jo1102/Hardware-Hack/audio/diagram_transistor.png

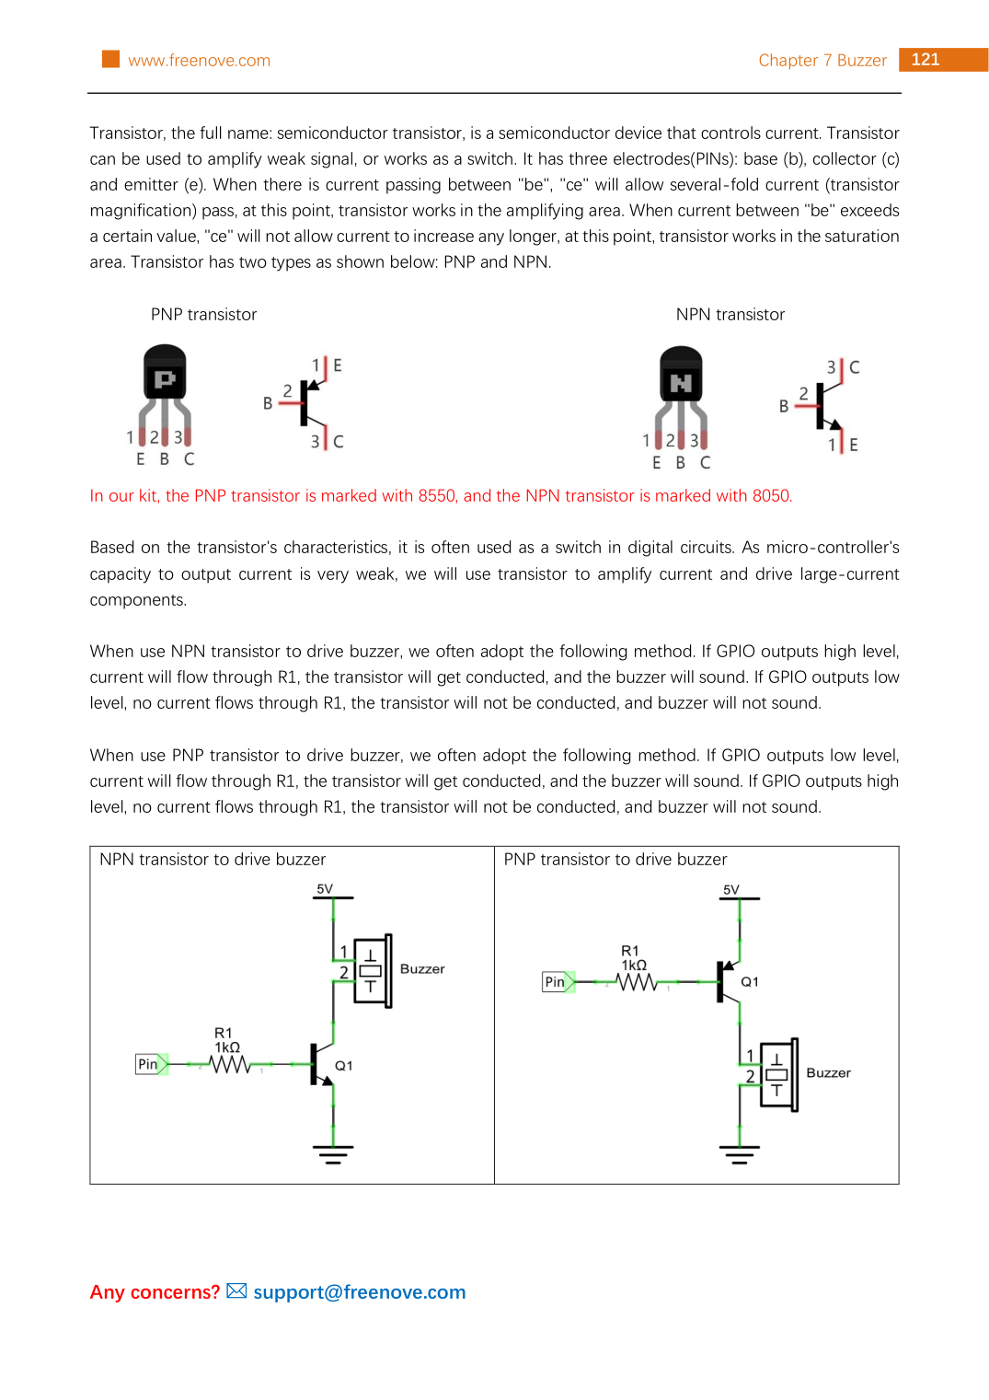
audio/diagram_transistor.png
