jo1102/Hardware-Hack/camera/XiaoCam/XiaoCam.ino

#include <Arduino.h>
#include "esp_camera.h"
#include <WiFi.h>

// The Check-in webcam: an 800x600 stream over WiFi, as CameraWebServer always
// was. Person detection runs on the laptop instead (site/bridge.py, YOLOX) -
// a model small enough for this chip could not tell a person from an empty
// room. Over USB it only says where its stream is, every two seconds, so the
// bridge never has to search the network for it.

// ===========================
// Select camera model in board_config.h
// ===========================
#include "board_config.h"

// ===========================
// WiFi credentials
// ===========================
// Kept out of git. Copy wifi_secrets.example.h to wifi_secrets.h in this
// folder and put your own network in it:
//
//     cp camera/XiaoCam/wifi_secrets.example.h camera/XiaoCam/wifi_secrets.h
//
// The __has_include guard means a fresh clone still COMPILES without that
// file - it just will not connect, and the compiler says why. Breaking the
// build for a missing secret would be a worse trade.
#if __has_include("wifi_secrets.h")
  #include "wifi_secrets.h"
#else
  #define WIFI_SSID     "YOUR_WIFI_NAME"
  #define WIFI_PASSWORD "YOUR_WIFI_PASSWORD"
  #warning "camera/XiaoCam/wifi_secrets.h missing - copy wifi_secrets.example.h to it"
#endif

const char *ssid = WIFI_SSID;
const char *password = WIFI_PASSWORD;

void startCameraServer();
void setupLedFlash();

void setup() {
  Serial.begin(115200);
  Serial.setDebugOutput(true);
  Serial.println();

  camera_config_t config;
  config.ledc_channel = LEDC_CHANNEL_0;
  config.ledc_timer = LEDC_TIMER_0;
  config.pin_d0 = Y2_GPIO_NUM;
  config.pin_d1 = Y3_GPIO_NUM;
  config.pin_d2 = Y4_GPIO_NUM;
  config.pin_d3 = Y5_GPIO_NUM;
  config.pin_d4 = Y6_GPIO_NUM;
  config.pin_d5 = Y7_GPIO_NUM;
  config.pin_d6 = Y8_GPIO_NUM;
  config.pin_d7 = Y9_GPIO_NUM;
  config.pin_xclk = XCLK_GPIO_NUM;
  config.pin_pclk = PCLK_GPIO_NUM;
  config.pin_vsync = VSYNC_GPIO_NUM;
  config.pin_href = HREF_GPIO_NUM;
  config.pin_sccb_sda = SIOD_GPIO_NUM;
  config.pin_sccb_scl = SIOC_GPIO_NUM;
  config.pin_pwdn = PWDN_GPIO_NUM;
  config.pin_reset = RESET_GPIO_NUM;
  config.xclk_freq_hz = 20000000;
  config.frame_size = FRAMESIZE_UXGA;
  config.pixel_format = PIXFORMAT_JPEG;  // for streaming
  //config.pixel_format = PIXFORMAT_RGB565; // for face detection/recognition
  config.grab_mode = CAMERA_GRAB_WHEN_EMPTY;
  config.fb_location = CAMERA_FB_IN_PSRAM;
  config.jpeg_quality = 12;
  config.fb_count = 1;

  // if PSRAM IC present, init with UXGA resolution and higher JPEG quality
  //                      for larger pre-allocated frame buffer.
  if (config.pixel_format == PIXFORMAT_JPEG) {
    if (psramFound()) {
      config.jpeg_quality = 10;
      config.fb_count = 2;
      config.grab_mode = CAMERA_GRAB_LATEST;
    } else {
      // Limit the frame size when PSRAM is not available
      config.frame_size = FRAMESIZE_SVGA;
      config.fb_location = CAMERA_FB_IN_DRAM;
    }
  } else {
    // Best option for face detection/recognition
    config.frame_size = FRAMESIZE_240X240;
#if CONFIG_IDF_TARGET_ESP32S3
    config.fb_count = 2;
#endif
  }

#if defined(CAMERA_MODEL_ESP_EYE)
  pinMode(13, INPUT_PULLUP);
  pinMode(14, INPUT_PULLUP);
#endif

  // camera init
  esp_err_t err = esp_camera_init(&config);
  if (err != ESP_OK) {
    Serial.printf("Camera init failed with error 0x%x", err);
    return;
  }

  sensor_t *s = esp_camera_sensor_get();
  // initial sensors are flipped vertically and colors are a bit saturated
  if (s->id.PID == OV3660_PID) {
    s->set_vflip(s, 1);        // flip it back
    s->set_brightness(s, 1);   // up the brightness just a bit
    s->set_saturation(s, -2);  // lower the saturation
  }
  // 800x600: sharp enough to see a face across the room, and still quick -
  // the sensor compresses each frame itself. Higher quality number = more
  // compression = higher FPS; 12 was picked in the web UI on 2026-09-04.
  if (config.pixel_format == PIXFORMAT_JPEG) {
    s->set_framesize(s, FRAMESIZE_SVGA);
    s->set_quality(s, 12);
  }

#if defined(CAMERA_MODEL_M5STACK_WIDE) || defined(CAMERA_MODEL_M5STACK_ESP32CAM)
  s->set_vflip(s, 1);
  s->set_hmirror(s, 1);
#endif

#if defined(CAMERA_MODEL_ESP32S3_EYE)
  s->set_vflip(s, 1);
#endif

// Setup LED FLash if LED pin is defined in camera_pins.h
#if defined(LED_GPIO_NUM)
  setupLedFlash();
#endif

  // No waiting for WiFi: the USB line below has to keep coming either way.
  // The server listens on every interface, so it answers once an address
  // arrives.
  WiFi.begin(ssid, password);
  WiFi.setSleep(false);
  startCameraServer();
}

void loop() {
  static bool told = false;
  if (!told && WiFi.isConnected()) {
    told = true;
    Serial.printf("Camera Ready! Use 'http://%s' to connect\n", WiFi.localIP().toString().c_str());
  }
  // ip is "" until it has joined the network.
  Serial.printf("{\"type\":0,\"name\":\"WIFI\",\"code\":0,\"data\":{\"ip\":\"%s\"}}\n",
                WiFi.isConnected() ? WiFi.localIP().toString().c_str() : "");
  delay(2000);
}
