jo1102/Hardware-Hack/(commit log)

2026-09-07 Kairo: pill dispenser with carer console and patient kiosk
    Access Granted hackathon build. A three-tube automatic pill dispenser for
    people who need prompting to take medicine and cannot afford an on-call
    carer.
    dispenser/ MicroPython agent on a Freenove ESP32-S3: scheduler, three gate
    servos, 1602 display, selectable chimes, state persisted to the
    board's own flash.
    site/ Two separate web screens - a carer console and a patient kiosk -
    plus a Python bridge that holds one USB serial connection open so
    commands reach the servos with nothing to restart.
    Safety rules worth naming: a dose more than an hour late is skipped rather
    than dispe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
    [partitions.csv]
2026-09-07 Fall back to demo data when no bridge answers
    Served over HTTP the site assumes a bridge is there and goes looking for
    one. On a static host - a GitHub Pages copy, say - nothing answers, and the
    first thing a visitor saw was "No device".
    Now: if nothing answers within the first few seconds AND the user has never
    picked a source themselves, switch to the simulation and say so in a toast.
    Guarded deliberately. Once a source is chosen explicitly it never fires
    again, so a bridge that drops mid-demo cannot silently turn into demo data
    while somebody is relying on it.
2026-09-08 Document that the XIAO camera pin list is not a wiring guide
2026-09-08 Find the camera by sweeping the network, and rotate serial ports
    Two problems that both appear the moment the XIAO is plugged in.
    Serial port auto-detect could stick. Both boards report Espressif's USB
    vendor id and sort identically, so the bridge would open the camera board,
    find no Kairo agent, close, and pick the same port again forever - never
    reaching the dispenser. It now remembers ports that answered without an
    agent and rotates past them, clearing the list once all have been tried in
    case deploy.py has just run.
    Finding the camera. Its address comes from DHCP and moves every boot, and
    once the XIAO runs off breadboard power there is no serial log to read it
    from at all. A static IP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
    [bridge.py]
2026-09-08 Write down the power budget
    Grounded in the code where possible: the agent never brings up WiFi, only one
    servo moves at a time, the servo and chime are sequential by construction,
    and the camera has no power-down line (PWDN is -1) so it draws whenever the
    XIAO is on.
    Flags plainly that only the servo stall current was ever measured and the
    rest are datasheet estimates.
2026-09-08 Rule out the 9V battery, and say what to use instead
    A PP3 cannot supply 0.95A - 1-2 ohm internal resistance means 1-2V is lost
    inside the cell - and dropping 9V to 5V linearly burns 3.8W as heat, past
    what an unheatsinked TO-220 will take. A USB power bank is already 5V,
    delivers 2A, and runs the build for about 40 hours.
    Also states plainly that 9V on either board's 5V pin will destroy it.
2026-09-18 Default to port 9000, and warn when localhost is already taken
    Docker Desktop binds 127.0.0.1:8000. The bridge binding 0.0.0.0:8000 still
    succeeds, but on Windows the specific bind wins for localhost, so the printed
    URL silently went to Docker while the LAN address worked. Nothing looked
    wrong in the log.
    Default moved to 9000, and the bridge now probes the port before binding and
    says so if something already answers there.
    [bridge.py]
2026-09-18 Mark the /24 assumption in the camera scan
2026-09-18 Ultrasonic presence, a chirp when the camera opens, serial logging
    --log FILE appends every serial console line to disk. The in-memory console
    is a 250-line ring buffer that dies with the process, which is no use for
    working out what happened before a crash.
    HC-SR04 on TRIG GPIO1 / ECHO GPIO40 - the only two pins this board has left.
    Sampled twice a second rather than in the 50ms command loop, because a ping
    into an empty room blocks for ~24ms waiting for an echo that never arrives.
    read_distance() returns None for "no reading" rather than a number, since a
    timeout genuinely means nothing is there and a figure would be a lie.
    Presence, not motion: the sensor reports distance, so what it ca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
    [bridge.py, hardware.py, main.py]
2026-09-23 Laptop person detection, 800x600 WiFi check-in camera
    The XIAO runs camera/XiaoCam again: an 800x600 stream, and its WiFi address
    over USB so the bridge never has to search for it. The bridge runs YOLOX on
    the camera's stills and drops a waiting pill at 60% sure of a person -
    models small enough for the XIAO (SenseCraft's included) scored an empty
    room as high as a person.
    Also: the ring text fits inside the circle, WiFi-only controls hide while
    the USB feed is live, and the camera IP prints in the terminal.
